hexbus/TI99_16K_Cartridge_Board/hardware/TI99-16K-v2a-converted.kicad_pcb

## KiCad design hardware/TI99-16K-v2a-converted.kicad_pcb (2026-11-09)

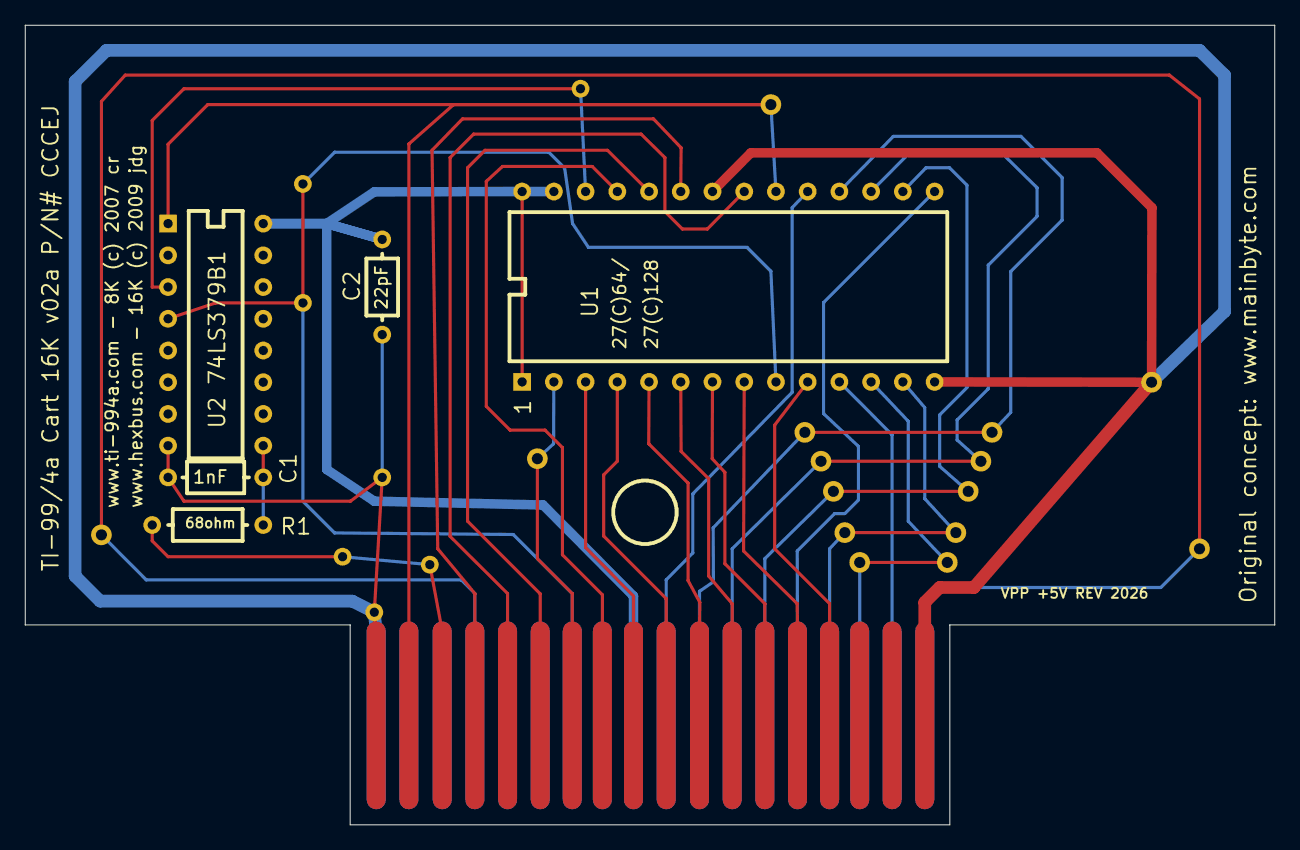
[picture p4: board TI99-16K-v2a-converted.kicad_pcb from above]

Board: 2 copper layers, 100.0 x 64.0 mm, 6 parts (0 on the bottom side), 14 nets.

Parts:
C1, C2: Original ExpressPCB geometry
J0: Original ExpressPCB geometry
R1: Original ExpressPCB geometry
U1, U2: Original ExpressPCB geometry

Connections:
N36: J0.S194, U1.2
N107: C2.1, U1.1, U1.27, U1.28, U2.16
N109: J0.S324, J0.S348, U1.17
N110: J0.S278, J0.S351, U1.12
N111: J0.S327, J0.S349, U1.16
N113: J0.S330, J0.S350, U1.13
N116: J0.S117, J0.S120
N154: J0.S459, J0.S497, U1.9, U2.4
N163: J0.S281, J0.S347, U1.18
N165: J0.S183, U1.20, U2.1
N171: J0.S427, U1.26, U2.3
N196: C1.2, C2.2, J0.S134, J0.S356, J0.S460, U1.14, U1.22, U2.8
N444: J0.S444, J0.S466, R1.2
N464: C1.1, R1.1, U2.9
