hexbus/TI99_16K_Cartridge_Board/(notices)

Notices in the files:
hardware/TI99-16K-v2a-converted.kicad_pcb:
www.ti-994a.com - 8K (c) 2007 cr
www.hexbus.com - 16K (c) 2009 jdg
